nvitya/armpofo/README.md

# armpofo
Atari Portfolio Reloaded with ARM Cortex-M
