nvitya/armpofo/armpofo_cpu/armpofo_cpu.kicad_pcb

## KiCad design armpofo_cpu/armpofo_cpu.kicad_pcb (2020-11-24)

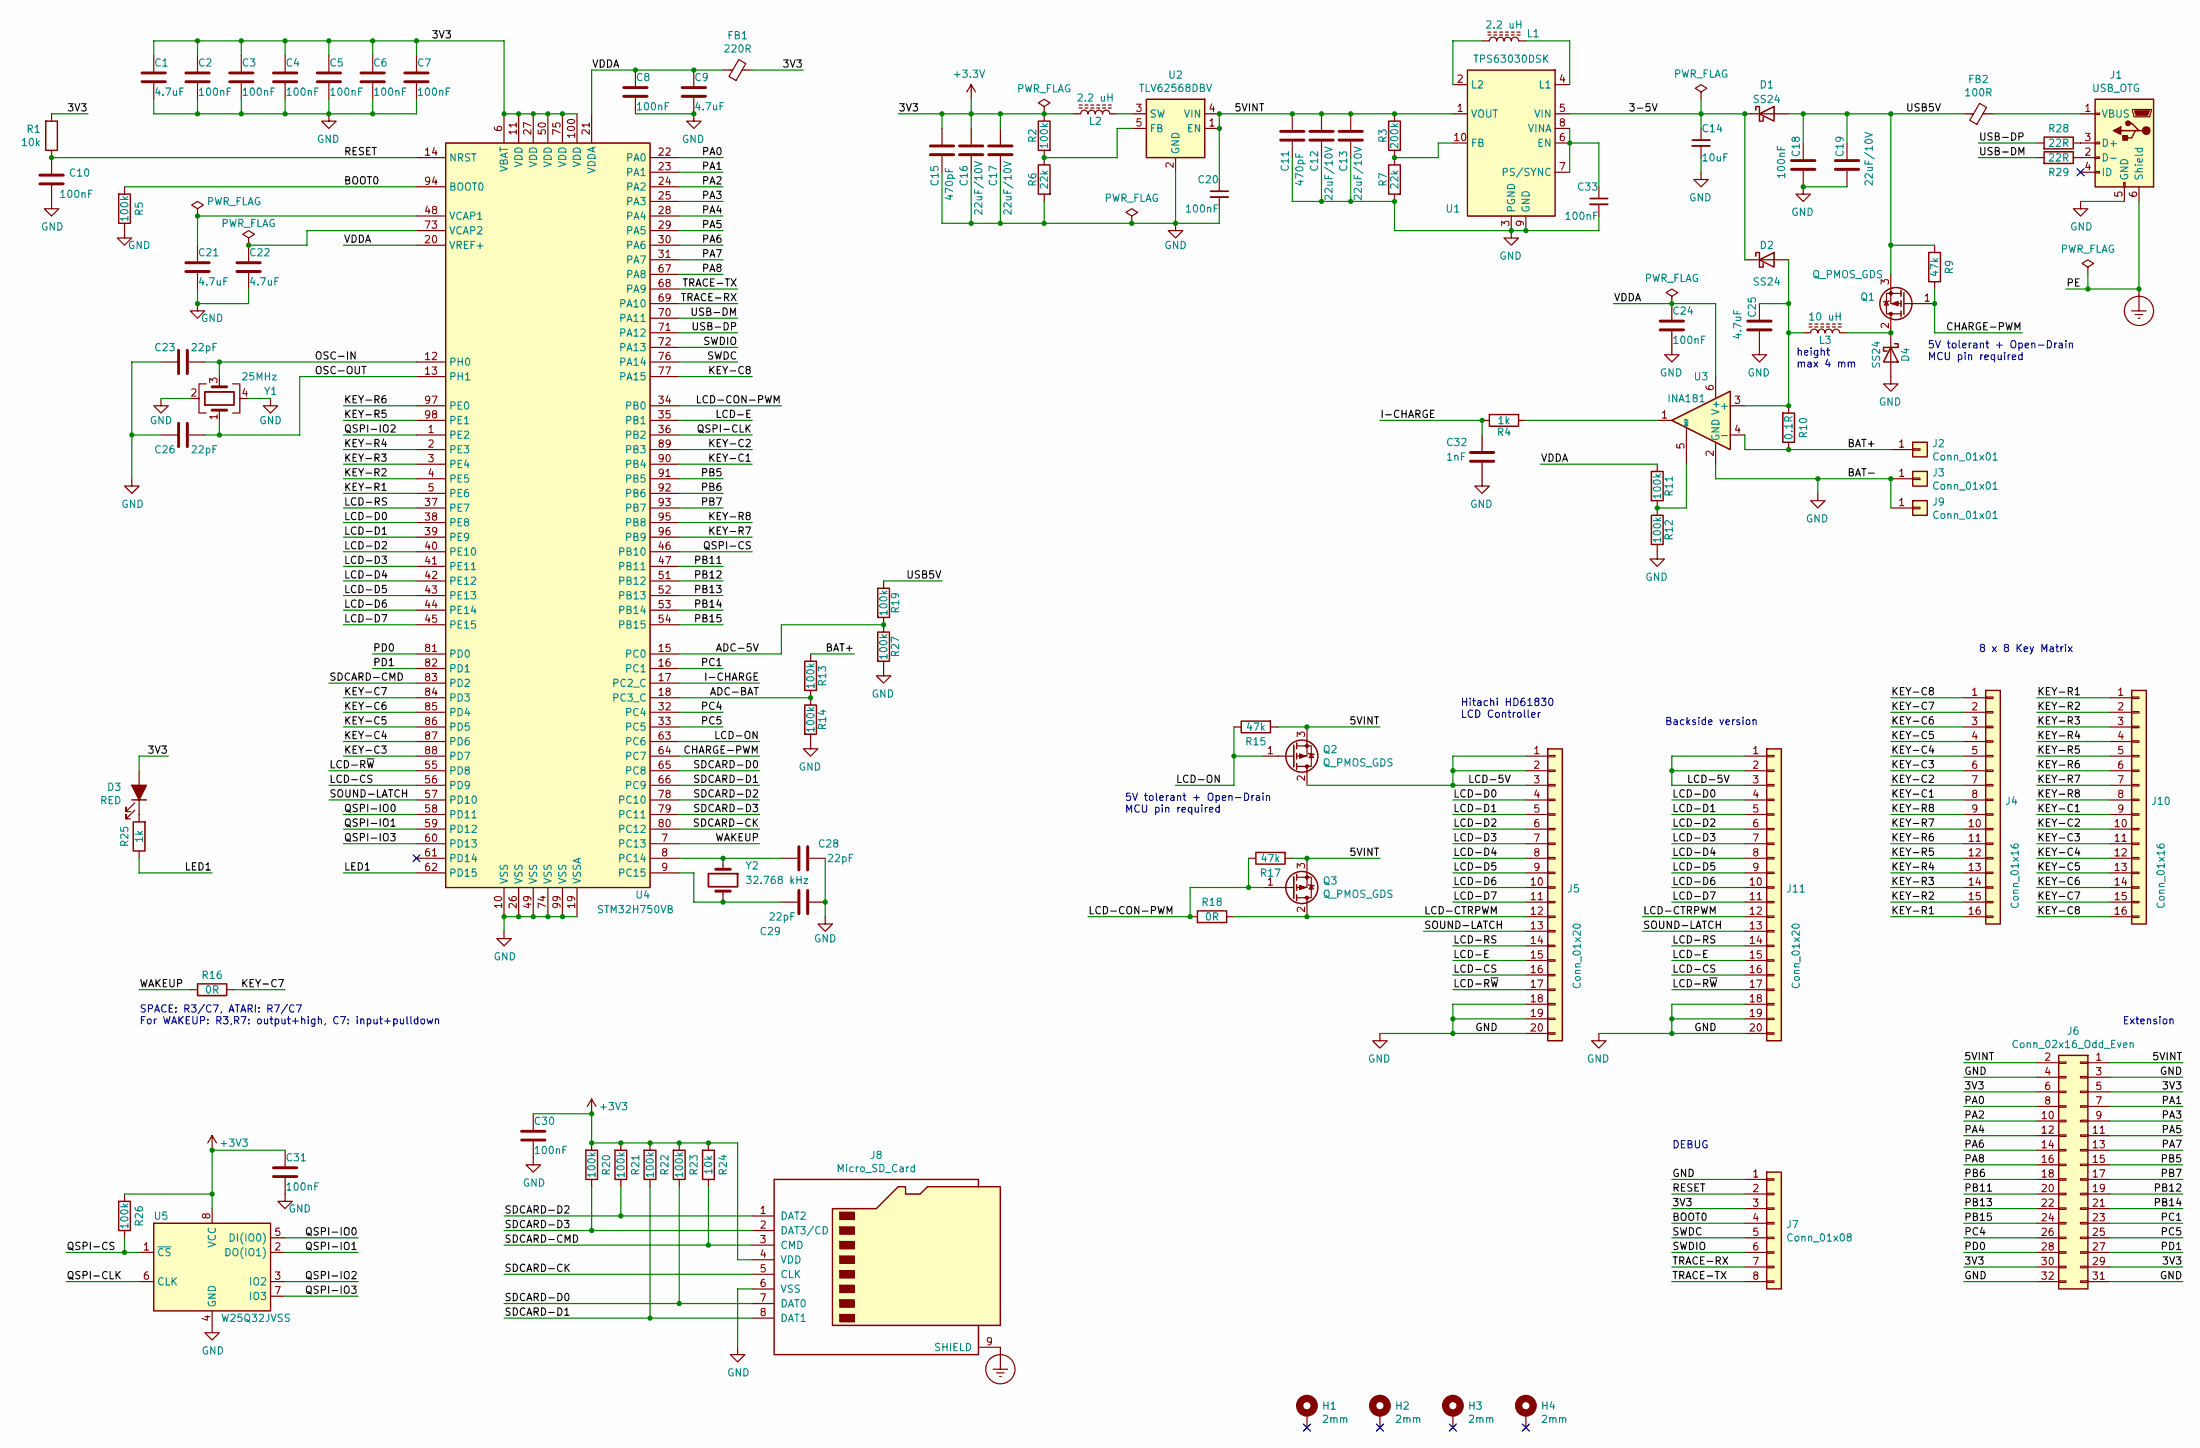
[picture p1: schematic armpofo_cpu.sch]

Parts:
C1, C9, C21, C22, C25: 4.7uF; C_0603_1608Metric
C2, C3, C4, C5, C6, C7, C8, C10, C18, C20, C24, C30, C31, C33: 100nF; C_0603_1608Metric
C11, C15: 470pF; C_0603_1608Metric
C12, C13, C16, C17, C19: 22uF/10V; C_1210_3225Metric
C14: 10uF; C_1210_3225Metric
C23, C26, C28, C29: 22pF; C_0603_1608Metric
C32: 1nF; C_0603_1608Metric
D1, D2, D4: SS24; D_1206_3216Metric
D3: RED; D_0603_1608Metric
FB1: 220R; L_0603_1608Metric
FB2: 100R; L_0603_1608Metric
H1, H2, H3, H4: 2mm; MountingHole_2.2mm_M2_DIN965_Pad
J1: USB_OTG; USB_Micro-B_Molex-105017-0001
J2, J3, J9: Conn_01x01; PinHeader_1x01_P2.54mm_Vertical
J4: Conn_01x16; TE_1-84953-6_1x16-1MP_P1.0mm_Horizontal
J5, J11: Conn_01x20; TE_2-84952-0_1x20-1MP_P1.0mm_Horizontal
J6: Conn_02x16_Odd_Even; Conn_Edge_PinSocket_2x16_2.54mm
J7: Conn_01x08; PinHeader_1x08_P2.54mm_Horizontal
J8: Micro_SD_Card; Conn_uSDcard
J10: Conn_01x16; PinHeader_1x16_P1.27mm_Vertical
L1, L2: 2.2 uH; L_Taiyo-Yuden_NR-40xx_HandSoldering
L3: 10 uH; L_Taiyo-Yuden_NR-40xx_HandSoldering
Q1, Q2, Q3: Q_PMOS_GDS; SOT-23
R1, R24: 10k; R_0603_1608Metric
R2, R5, R11, R12, R13, R14, R19, R20, R21, R22, R23, R26, R27: 100k; R_0603_1608Metric
R3: 200k; R_0603_1608Metric
R4, R25: 1k; R_0603_1608Metric
R6, R7: 22k; R_0603_1608Metric
R9, R15, R17: 47k; R_0603_1608Metric
R10: 0.1R; R_1206_3216Metric
R16, R18: 0R; R_0603_1608Metric
R28, R29: 22R; R_0603_1608Metric
U1: TPS63030DSK; WSON-10-1EP_2.5x2.5mm_P0.5mm_EP1.2x2mm
U2: TLV62568DBV; SOT-23-5
U3: INA181; SOT-23-6
U4: STM32H750VB; LQFP-100_14x14mm_P0.5mm
U5: W25Q32JVSS; SO-8_5.3x6.2mm_P1.27mm
Y1: 25MHz; Crystal_SMD_3225-4Pin_3.2x2.5mm
Y2: 32.768 kHz; Crystal_DS26_D2.0mm_L6.0mm_Horizontal_1EP_style1

Connections:
/3-5V: C14.1, D1.1 (K), D2.1 (K), U1.5 (VIN)
/5VINT: C11.1, C12.1, C13.1, C20.1, J6.1, J6.2, Q2.3 (S), Q3.3 (S), R3.1, R15.2, R17.2, U1.1 (VOUT), U2.1 (EN), U2.4 (VIN)
/ADC-5V: R19.2, R27.1, U4.15 (PC0)
/ADC-BAT: R13.2, R14.1, U4.18 (PC3_C)
/BAT+: J2.1, R10.1, R13.1, U3.4 (-)
/BOOT0: J7.4, R5.2, U4.94 (BOOT0)
/CHARGE-PWM: Q1.1 (G), R9.1, U4.64 (PC7)
/I-CHARGE: C32.1, R4.2, U4.17 (PC2_C)
/KEY-C1: J4.8, J10.9, U4.90 (PB4)
/KEY-C2: J4.7, J10.10, U4.89 (PB3)
/KEY-C3: J4.6, J10.11, U4.88 (PD7)
/KEY-C4: J4.5, J10.12, U4.87 (PD6)
/KEY-C5: J4.4, J10.13, U4.86 (PD5)
/KEY-C6: J4.3, J10.14, U4.85 (PD4)
/KEY-C7: J4.2, J10.15, R16.1, U4.84 (PD3)
/KEY-C8: J4.1, J10.16, U4.77 (PA15)
/KEY-R1: J4.16, J10.1, U4.5 (PE6)
/KEY-R2: J4.15, J10.2, U4.4 (PE5)
/KEY-R3: J4.14, J10.3, U4.3 (PE4)
/KEY-R4: J4.13, J10.4, U4.2 (PE3)
/KEY-R5: J4.12, J10.5, U4.98 (PE1)
/KEY-R6: J4.11, J10.6, U4.97 (PE0)
/KEY-R7: J4.10, J10.7, U4.96 (PB9)
/KEY-R8: J4.9, J10.8, U4.95 (PB8)
/LCD-5V: J5.1, J5.2, J5.3, J11.1, J11.2, J11.3, Q2.2 (D)
/LCD-CON-PWM: Q3.1 (G), R17.1, R18.2, U4.34 (PB0)
/LCD-CS: J5.16, J11.16, U4.56 (PD9)
/LCD-CTRPWM: J5.12, J11.12, Q3.2 (D), R18.1
/LCD-D0: J5.4, J11.4, U4.38 (PE8)
/LCD-D1: J5.5, J11.5, U4.39 (PE9)
/LCD-D2: J5.6, J11.6, U4.40 (PE10)
/LCD-D3: J5.7, J11.7, U4.41 (PE11)
/LCD-D4: J5.8, J11.8, U4.42 (PE12)
/LCD-D5: J5.9, J11.9, U4.43 (PE13)
/LCD-D6: J5.10, J11.10, U4.44 (PE14)
/LCD-D7: J5.11, J11.11, U4.45 (PE15)
/LCD-E: J5.15, J11.15, U4.35 (PB1)
/LCD-ON: Q2.1 (G), R15.1, U4.63 (PC6)
/LCD-RS: J5.14, J11.14, U4.37 (PE7)
/LCD-R~W: J5.17, J11.17, U4.55 (PD8)
/LED1: R25.1, U4.62 (PD15)
/OSC-IN: C23.1, U4.12 (PH0), Y1.3
/OSC-OUT: C26.1, U4.13 (PH1), Y1.1
/PA0: J6.8, U4.22 (PA0)
/PA1: J6.7, U4.23 (PA1)
/PA2: J6.10, U4.24 (PA2)
/PA3: J6.9, U4.25 (PA3)
/PA4: J6.12, U4.28 (PA4)
/PA5: J6.11, U4.29 (PA5)
/PA6: J6.14, U4.30 (PA6)
/PA7: J6.13, U4.31 (PA7)
/PA8: J6.16, U4.67 (PA8)
/PB5: J6.15, U4.91 (PB5)
/PB6: J6.18, U4.92 (PB6)
/PB7: J6.17, U4.93 (PB7)
/PB11: J6.20, U4.47 (PB11)
/PB12: J6.19, U4.51 (PB12)
/PB13: J6.22, U4.52 (PB13)
/PB14: J6.21, U4.53 (PB14)
/PB15: J6.24, U4.54 (PB15)
/PC1: J6.23, U4.16 (PC1)
/PC4: J6.26, U4.32 (PC4)
/PC5: J6.25, U4.33 (PC5)
/PD0: J6.28, U4.81 (PD0)
/PD1: J6.27, U4.82 (PD1)
/QSPI-CLK: U4.36 (PB2), U5.6 (CLK)
/QSPI-CS: R26.1, U4.46 (PB10), U5.1 (~CS)
/QSPI-IO0: U4.58 (PD11), U5.5 (DI(IO0))
/QSPI-IO1: U4.59 (PD12), U5.2 (DO(IO1))
/QSPI-IO2: U4.1 (PE2), U5.3 (IO2)
/QSPI-IO3: U4.60 (PD13), U5.7 (IO3)
/RESET: C10.1, J7.2, R1.1, U4.14 (NRST)
/SDCARD-CK: J8.5 (CLK), U4.80 (PC12)
/SDCARD-CMD: J8.3 (CMD), R24.1, U4.83 (PD2)
/SDCARD-D0: J8.7 (DAT0), R23.1, U4.65 (PC8)
/SDCARD-D1: J8.8 (DAT1), R22.1, U4.66 (PC9)
/SDCARD-D2: J8.1 (DAT2), R21.1, U4.78 (PC10)
/SDCARD-D3: J8.2 (DAT3/CD), R20.1, U4.79 (PC11)
/SOUND-LATCH: J5.13, J11.13, U4.57 (PD10)
/SWDC: J7.5, U4.76 (PA14)
/SWDIO: J7.6, U4.72 (PA13)
/TRACE-RX: J7.7, U4.69 (PA10)
/TRACE-TX: J7.8, U4.68 (PA9)
/USB5V: C18.1, C19.1, D1.2 (A), FB2.1, Q1.3 (S), R9.2, R19.1
/USB-DM: R29.2, U4.70 (PA11)
/USB-DP: R28.2, U4.71 (PA12)
/VDDA: C8.1, C9.1, C24.1, FB1.1, R11.1, U3.6 (V+), U4.20 (VREF+), U4.21 (VDDA)
/WAKEUP: R16.2, U4.7 (PC13)
Earth_Protective: J1.6 (Shield), J8.9 (SHIELD)
GND: C1.2, C2.2, C3.2, C4.2, C5.2, C6.2, C7.2, C8.2, C9.2, C10.2, C11.2, C12.2, C13.2, C14.2, C15.2, C16.2, C17.2, C18.2, C19.2, C20.2, C21.2, C22.2, C23.2, C24.2, C25.2, C26.2, C28.2, C29.2, C30.2, C31.2, C32.2, C33.2, D4.2 (A), J1.5 (GND), J3.1, J5.18, J5.19, J5.20, J6.3, J6.4, J6.31, J6.32, J7.1, J8.6 (VSS), J9.1, J11.18, J11.19, J11.20, R5.1, R6.2, R7.2, R12.2, R14.2, R27.2, U1.3 (PGND), U1.9 (GND), U1.11 (PGND), U2.2 (GND), U3.2 (GND), U4.10 (VSS), U4.19 (VSSA), U4.26 (VSS), U4.49 (VSS), U4.74 (VSS), U4.99 (VSS), U5.4 (GND), Y1.2, Y1.4
unnamed: C21.1, U4.48 (VCAP1)
unnamed: C22.1, U4.73 (VCAP2)
unnamed: C25.1, D2.2 (A), L3.2, R10.2, U3.3 (+)
unnamed: C28.1, U4.8 (PC14), Y2.1
unnamed: C29.1, U4.9 (PC15), Y2.2
unnamed: C33.1, U1.6 (EN), U1.7 (PS/SYNC), U1.8 (VINA)
unnamed: D3.1 (K), R25.2
unnamed: D4.1 (K), L3.1, Q1.2 (D)
unnamed: FB2.2, J1.1 (VBUS)
unnamed: J1.2 (D-), R29.1
unnamed: J1.3 (D+), R28.1
unnamed: L1.1, U1.4 (L1)
unnamed: L1.2, U1.2 (L2)
unnamed: L2.1, U2.3 (SW)
unnamed: R2.2, R6.1, U2.5 (FB)
unnamed: R3.2, R7.1, U1.10 (FB)
unnamed: R4.1, U3.1
unnamed: R11.2, R12.1, U3.5 (REF)

Notes on the sheet:
Hitachi HD61830 LCD Controller
8 x 8 Key Matrix
Extension
DEBUG
5V tolerant + Open-Drain MCU pin required
height max 4 mm
SPACE: R3/C7, ATARI: R7/C7 For WAKEUP: R3,R7: output+high, C7: input+pulldown
Backside version

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
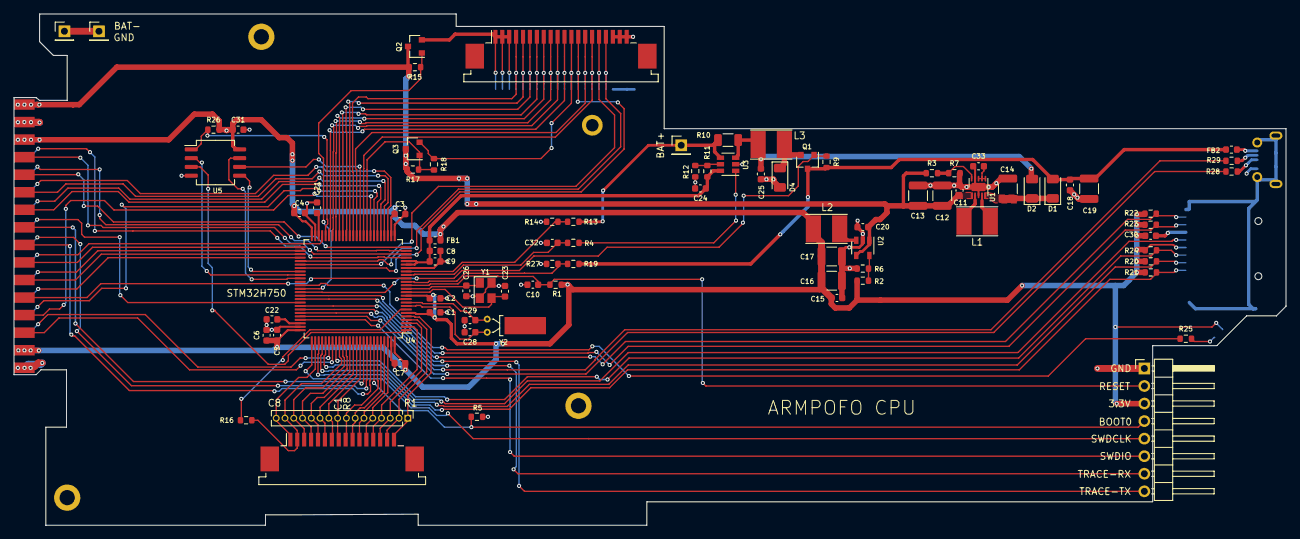
[picture p2: board armpofo_cpu.kicad_pcb from above]

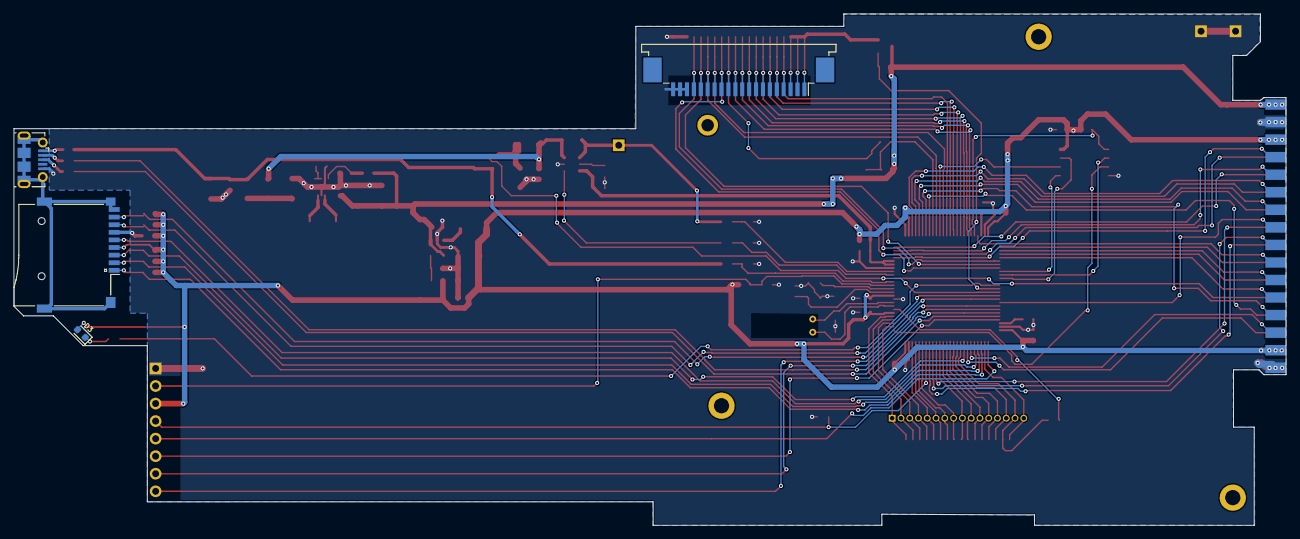
[picture p3: board armpofo_cpu.kicad_pcb from below]

Board: 2 copper layers, 184.1 x 74.0 mm, 94 parts (4 on the bottom side), 109 nets.
