nvitya/armpofo/armpofo_keyboard/armpofo_keyboard.kicad_pcb

## KiCad design armpofo_keyboard/armpofo_keyboard.kicad_pcb (2020-11-24)

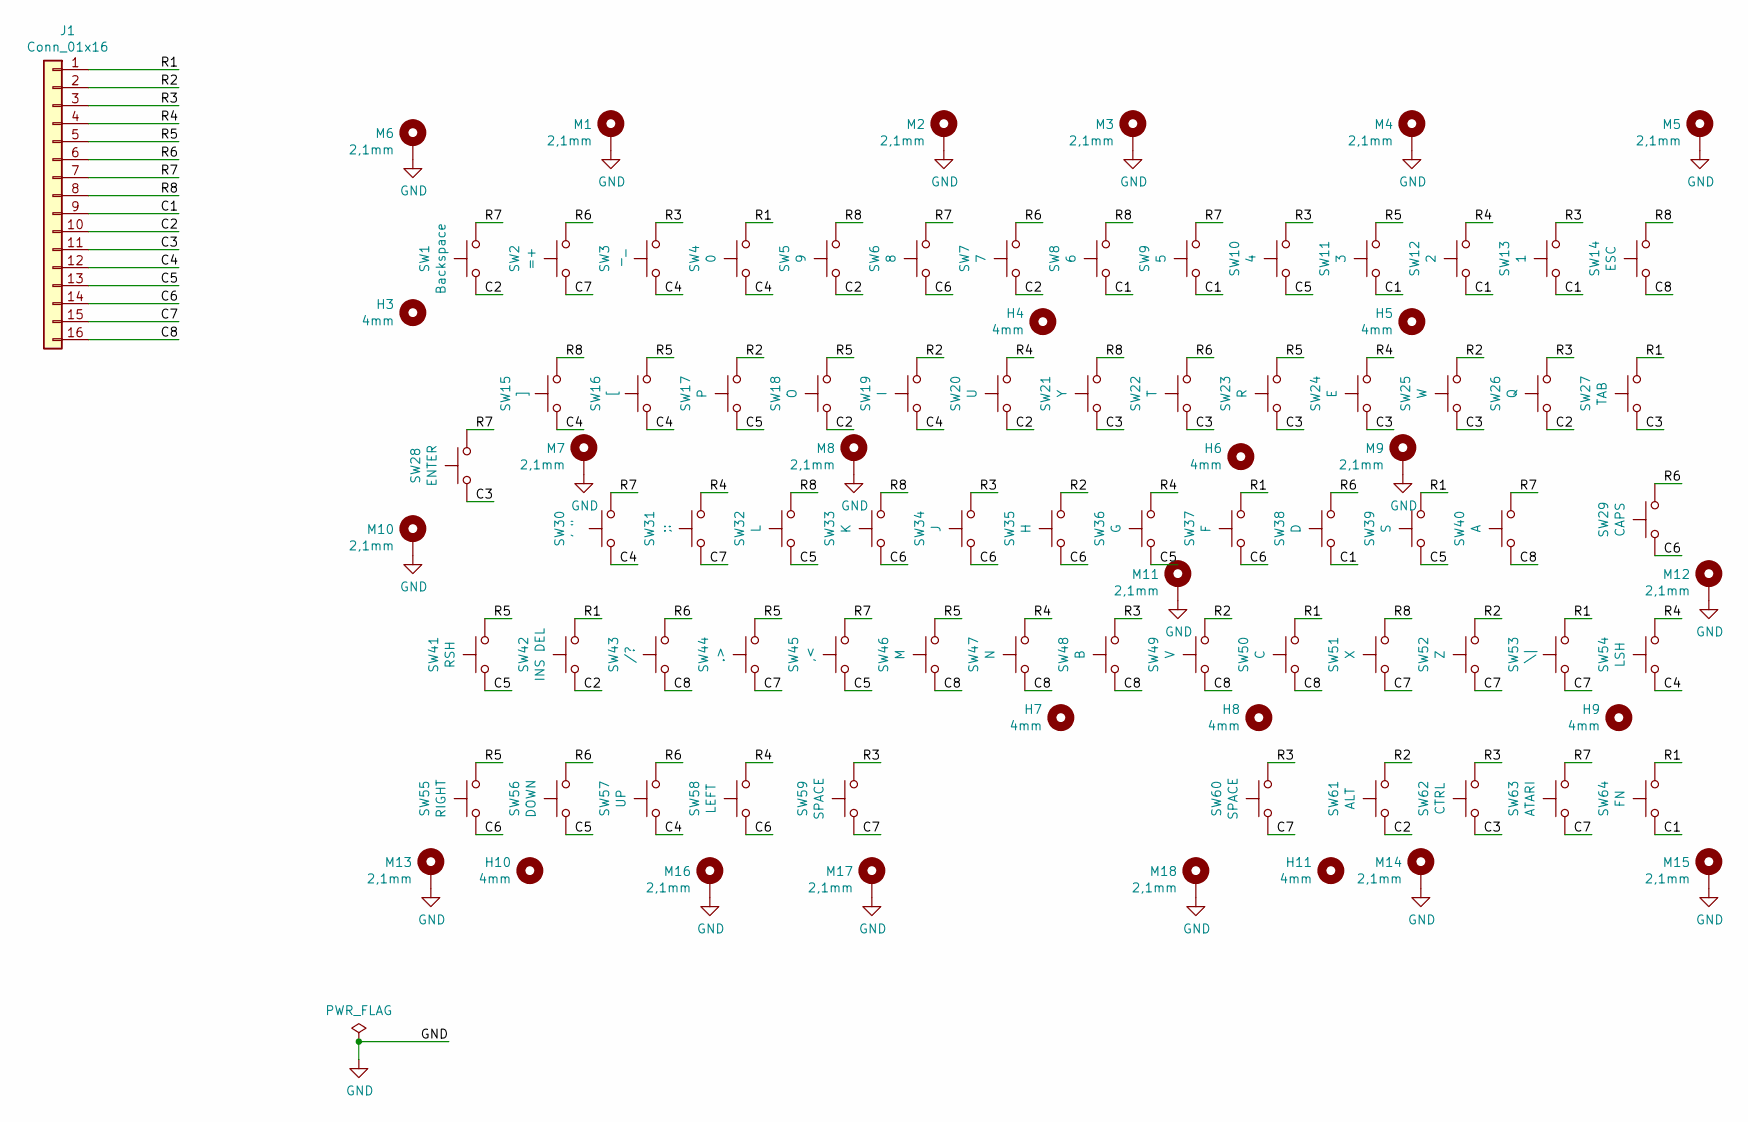
[picture p4: schematic armpofo_keyboard.sch]

Parts:
H3, H4, H5, H6, H7, H8, H9, H10, H11: 4mm; MountingHole_4mm
J1: Conn_01x16; TE_1-84953-6_1x16-1MP_P1.0mm_Horizontal
M1, M2, M3, M4, M5, M6, M7, M8, M9, M10, M11, M12, M13, M14, M15, M16, M17, M18: 2,1mm; MountingHole_2.2mm_M2_DIN965_Pad
SW1: Backspace; Key_landing
SW2: =+; Key_landing
SW3: -_; Key_landing
SW4: 0; Key_landing
SW5: 9; Key_landing
SW6: 8; Key_landing
SW7: 7; Key_landing
SW8: 6; Key_landing
SW9: 5; Key_landing
SW10: 4; Key_landing
SW11: 3; Key_landing
SW12: 2; Key_landing
SW13: 1; Key_landing
SW14: ESC; Key_landing
SW15: ]; Key_landing
SW16: [; Key_landing
SW17: P; Key_landing
SW18: O; Key_landing
SW19: I; Key_landing
SW20: U; Key_landing
SW21: Y; Key_landing
SW22: T; Key_landing
SW23: R; Key_landing
SW24: E; Key_landing
SW25: W; Key_landing
SW26: Q; Key_landing
SW27: TAB; Key_landing
SW28: ENTER; Key_landing
SW29: CAPS; Key_landing
SW30: ' \"; Key_landing
SW31: ;:; Key_landing
SW32: L; Key_landing
SW33: K; Key_landing
SW34: J; Key_landing
SW35: H; Key_landing
SW36: G; Key_landing
SW37: F; Key_landing
SW38: D; Key_landing
SW39: S; Key_landing
SW40: A; Key_landing
SW41: RSH; Key_landing
SW42: INS DEL; Key_landing
SW43: /?; Key_landing
SW44: .>; Key_landing
SW45: ,<; Key_landing
SW46: M; Key_landing
SW47: N; Key_landing
SW48: B; Key_landing
SW49: V; Key_landing
SW50: C; Key_landing
SW51: X; Key_landing
SW52: Z; Key_landing
SW53: \\|; Key_landing
SW54: LSH; Key_landing
SW55: RIGHT; Key_landing
SW56: DOWN; Key_landing
SW57: UP; Key_landing
SW58: LEFT; Key_landing
SW59, SW60: SPACE; Key_landing
SW61: ALT; Key_landing
SW62: CTRL; Key_landing
SW63: ATARI; Key_landing
SW64: FN; Key_landing

Connections:
/C1: J1.9, SW8.2, SW9.2, SW11.2, SW12.2, SW13.2, SW38.2, SW64.2
/C2: J1.10, SW1.2, SW5.2, SW7.2, SW18.2, SW20.2, SW26.2, SW42.2, SW61.2
/C3: J1.11, SW21.2, SW22.2, SW23.2, SW24.2, SW25.2, SW27.2, SW28.2, SW62.2
/C4: J1.12, SW3.2, SW4.2, SW15.2, SW16.2, SW19.2, SW30.2, SW54.2, SW57.2
/C5: J1.13, SW10.2, SW17.2, SW32.2, SW36.2, SW39.2, SW41.2, SW45.2, SW56.2
/C6: J1.14, SW6.2, SW29.2, SW33.2, SW34.2, SW35.2, SW37.2, SW55.2, SW58.2
/C7: J1.15, SW2.2, SW31.2, SW44.2, SW51.2, SW52.2, SW53.2, SW59.2, SW60.2, SW63.2
/C8: J1.16, SW14.2, SW40.2, SW43.2, SW46.2, SW47.2, SW48.2, SW49.2, SW50.2
/R1: J1.1, SW4.1, SW27.1, SW37.1, SW39.1, SW42.1, SW50.1, SW53.1, SW64.1
/R2: J1.2, SW17.1, SW19.1, SW25.1, SW35.1, SW49.1, SW52.1, SW61.1
/R3: J1.3, SW3.1, SW10.1, SW13.1, SW26.1, SW34.1, SW48.1, SW59.1, SW60.1, SW62.1
/R4: J1.4, SW12.1, SW20.1, SW24.1, SW31.1, SW36.1, SW47.1, SW54.1, SW58.1
/R5: J1.5, SW11.1, SW16.1, SW18.1, SW23.1, SW41.1, SW44.1, SW46.1, SW55.1
/R6: J1.6, SW2.1, SW7.1, SW22.1, SW29.1, SW38.1, SW43.1, SW56.1, SW57.1
/R7: J1.7, SW1.1, SW6.1, SW9.1, SW28.1, SW30.1, SW40.1, SW45.1, SW63.1
/R8: J1.8, SW5.1, SW8.1, SW14.1, SW15.1, SW21.1, SW32.1, SW33.1, SW51.1
GND: M1.1, M2.1, M3.1, M4.1, M5.1, M6.1, M7.1, M8.1, M9.1, M10.1, M11.1, M12.1, M13.1, M14.1, M15.1, M16.1, M17.1, M18.1

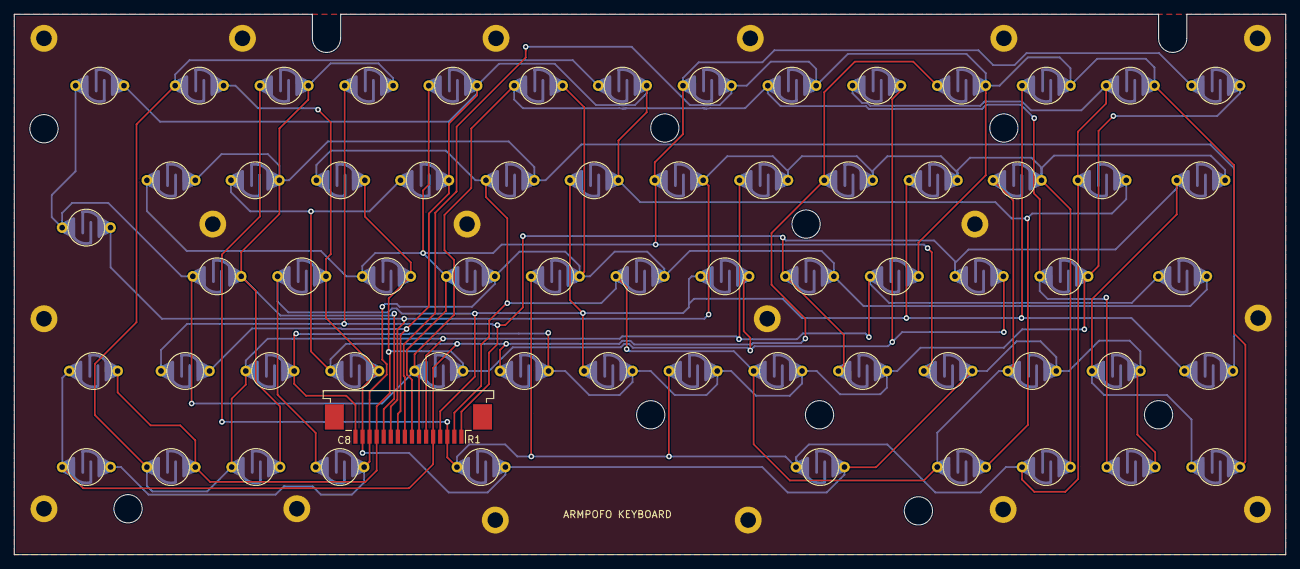
[picture p5: board armpofo_keyboard.kicad_pcb from above]

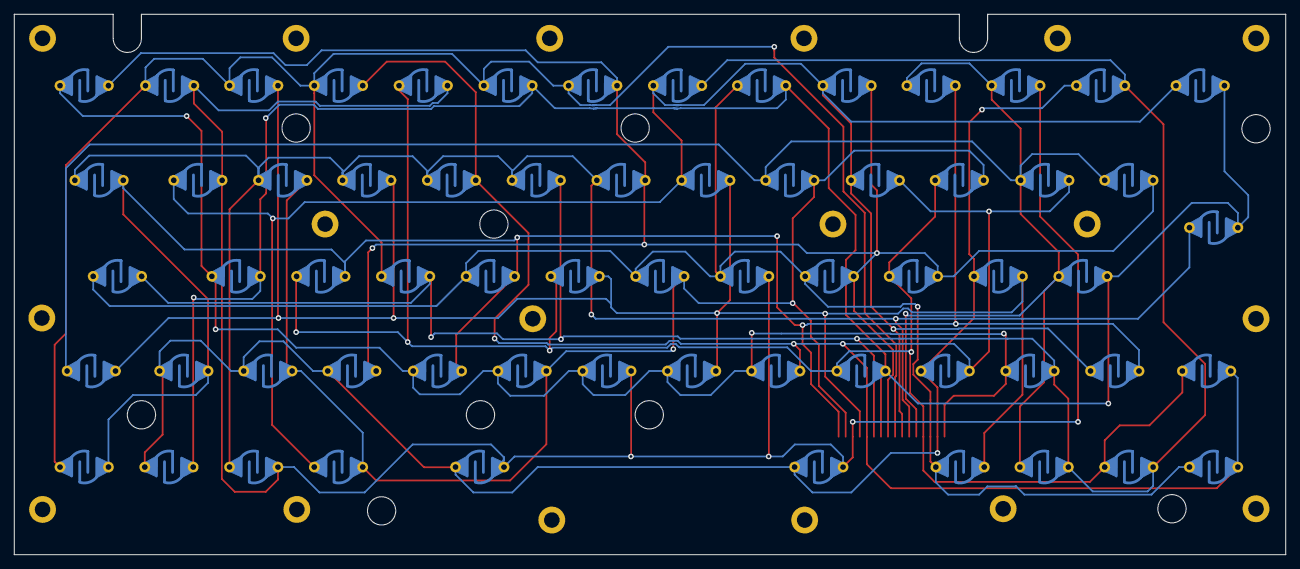
[picture p6: board armpofo_keyboard.kicad_pcb from below]

Board: 2 copper layers, 180.0 x 76.5 mm, 92 parts (64 on the bottom side), 17 nets.
