nvitya/armpofo/armpofo_cpu/cubemx/cubemx.ioc

PD12.GPIO_Label=QSPI-IO1
PC12.Signal=SDMMC1_CK
PB13.Signal=ETH_TXD1
PD6.GPIO_Label=KEY-R5
PE6.GPIO_Label=KEY-C8
PD4.Signal=GPIO_Output
PB6.Signal=FDCAN2_TX
PD0.Signal=FDCAN1_RX
PD8.Signal=GPIO_Output
PE5.Signal=GPIO_Output
PE1.Signal=GPIO_Output
PB2.Signal=QUADSPI_CLK
PE9.Signal=GPIO_Output
PB1.GPIO_Label=LCD-E
PE4.GPIO_Label=KEY-C6
PE2.Signal=QUADSPI_BK1_IO2
PA8.Signal=RCC_MCO_1
PE10.Signal=GPIO_Output
PA0.Signal=ADC1_INP16
PB9.Signal=GPIO_Output
PB1.Signal=GPIO_Output
PD12.Signal=QUADSPI_BK1_IO1
PC3_C.GPIO_Label=ADC_VBAT
PA10.Signal=USART1_RX
PE12.GPIO_Label=LCD-D4
PE10.GPIO_Label=LCD-D2
PD9.GPIO_Label=LCD-CS
PA9.GPIO_Label=TRACE-TX
PC13.Signal=PWR_WKUP2
PD3.Signal=GPIO_Output
PD7.Signal=GPIO_Output
PD1.Signal=FDCAN1_TX
PA11.GPIO_Label=USB-DM
PD10.Signal=GPIO_Output
PB8.GPIO_Label=KEY-C1
PE8.GPIO_Label=LCD-D0
PA9.Signal=USART1_TX
PE9.GPIO_Label=LCD-D1
PB10.Signal=QUADSPI_BK1_NCS
PB14.Signal=USB_OTG_HS_DM
PA5.Signal=COMP_DAC12_group
PE1.GPIO_Label=KEY-C4
PE14.Signal=GPIO_Output
PE15.Signal=GPIO_Output
PE8.Signal=GPIO_Output
PA4.Signal=COMP_DAC11_group
PB5.Signal=FDCAN2_RX
PE13.GPIO_Label=LCD-D5
PD11.Signal=QUADSPI_BK1_IO0
PE5.GPIO_Label=KEY-C7
PC12.GPIO_Label=SDCARD-CK
PA11.Signal=USB_OTG_FS_DM
PE3.Signal=GPIO_Output
PD2.Signal=SDMMC1_CMD
PB0.Signal=GPIO_Output
PC1.Signal=ETH_MDC
PD2.GPIO_Label=SDCARD-CMD
Mcu.UserName=STM32H750VBTx
PE11.GPIO_Label=LCD-D3
PC10.Signal=SDMMC1_D2
PB0.GPIO_Label=LCD-CON-PWM
PB11.Signal=ETH_TX_EN
PB15.Signal=USB_OTG_HS_DP
PD13.Signal=QUADSPI_BK1_IO3
PA12.Signal=USB_OTG_FS_DP
PD11.GPIO_Label=QSPI-IO0
PE13.Signal=GPIO_Output
PC11.GPIO_Label=SDCARD-D3
PA10.GPIO_Label=TRACE-RX
PB7.Signal=I2C1_SDA
PE4.Signal=GPIO_Output
PD7.GPIO_Label=KEY-R6
PD13.GPIO_Label=QSPI-IO3
PA6.Signal=ADCx_INP3
PD5.GPIO_Label=KEY-R4
PE0.GPIO_Label=KEY-C3
PC5.Signal=ETH_RXD1
PD3.GPIO_Label=KEY-R2
PE7.Signal=GPIO_Output
PD6.Signal=GPIO_Output
PE2.GPIO_Label=QSPI-IO2
PA3.Signal=ADCx_INP15
PB9.GPIO_Label=KEY-C2
PC10.GPIO_Label=SDCARD-D2
PC9.GPIO_Label=SDCARD-D1
PC11.Signal=SDMMC1_D3
PC8.Signal=SDMMC1_D0
PC4.Signal=ETH_RXD0
PE14.GPIO_Label=LCD-D6
PD9.Signal=GPIO_Output
PD5.Signal=GPIO_Output
PA12.GPIO_Label=USB-DP
PD8.GPIO_Label=LCD-RW
PC8.GPIO_Label=SDCARD-D0
PE15.GPIO_Label=LCD-D7
PB10.GPIO_Label=QSPI-CS
PD10.GPIO_Label=SOUND-LATCH
PE11.Signal=GPIO_Output
PA1.Signal=ETH_REF_CLK
PD4.GPIO_Label=KEY-R3
PE6.Signal=GPIO_Output
PE0.Signal=GPIO_Output
PE7.GPIO_Label=LCD-RS
PE12.Signal=GPIO_Output
PA2.Signal=ETH_MDIO
PB2.GPIO_Label=QSPI-CLK
PC3_C.Signal=ADC3_INP1
PB8.Signal=GPIO_Output
PE3.GPIO_Label=KEY-C5
PC9.Signal=SDMMC1_D1
PB12.Signal=ETH_TXD0
PA7.Signal=ETH_CRS_DV
