nvitya/armpofo/sw/armpofo_sys/board/armpofo/board.h

/* -----------------------------------------------------------------------------
 * This file is a part of the NVCM Tests project: https://github.com/nvitya/nvcmtests
 * Copyright (c) 2018 Viktor Nagy, nvitya
 *
 * This software is provided 'as-is', without any express or implied warranty.
 * In no event will the authors be held liable for any damages arising from
 * the use of this software. Permission is granted to anyone to use this
 * software for any purpose, including commercial applications, and to alter
 * it and redistribute it freely, subject to the following restrictions:
 *
 * 1. The origin of this software must not be misrepresented; you must not
 *    claim that you wrote the original software. If you use this software in
 *    a product, an acknowledgment in the product documentation would be
 *    appreciated but is not required.
 *
 * 2. Altered source versions must be plainly marked as such, and must not be
 *    misrepresented as being the original software.
 *
 * 3. This notice may not be removed or altered from any source distribution.
 * --------------------------------------------------------------------------- */
/*
 *  file:     board/armpofo/board.h
 *  brief:    Board specific settings for the project
 *  version:  1.00
 *  date:     2020-12-04
 *  authors:  nvitya
*/

#ifndef BOARD_H_
#define BOARD_H_

#define BOARD_ARMPOFO
#define BOARD_NAME "ARMPOFO (Atari Portfolio Upgrade)"
#define MCU_STM32H750VB
#define MCU_INPUT_FREQ    12000000

#define PRINTF_SUPPORT_FULL

#define MCU_CLOCK_SPEED  100000000  // run only at 100 MHz to spare some energy

#define SYS_APPLICATION          0  // 0 = system

#endif /* BOARD_H_ */
