nvitya/armpofo/sw_tests/armpofo_hwtests/src/strparse.h

// strparse.h
//
// light string parser using pointers, avoiding copiing

#ifndef __STRPARSE_H_
#define __STRPARSE_H_

class TStrParseObj
{
  public:
    char * bufstart;
    char * bufend;

    char * readptr;    // current parsing position

    char * prevptr;    // usually signs token start
    int prevlen;       // usually signs token length

    char commentmarker = '#';

    TStrParseObj();
    TStrParseObj(char * astr, int buflen = 0);

    void Init(char * astr, int buflen = 0);

    void SkipSpaces(bool askiplineend = true);
    void SkipWhite();

    bool ReadLine();                 // sets prevptr, prevlen
    bool ReadTo(const char * checkchars);  // sets prevptr, prevlen
    bool ReadToChar(char achar);     // sets prevptr, prevlen
    bool ReadIdentifier();           // sets prevptr, prevlen
    bool ReadAlphaNum();             // sets prevptr, prevlen
    bool ReadDecimalNumbers();       // sets prevptr, prevlen
    bool ReadHexNumbers();           // sets prevptr, prevlen
    bool ReadQuotedString();
    bool CheckSymbol(const char * checkstring);
    bool SearchPattern(const char * checkchars);  // sets prevptr, prevlen

    double ParseFloatNumber();

    bool ComparePrev(const char * checkstring);
    bool UCComparePrev(const char * checkstring);
    int PrevToInt();
    unsigned PrevHexToInt();


    int GetLineNum(const char * pos);
    int GetLineNum();
};

typedef TStrParseObj *  PStrParseObj;

bool PCharCompare(char * * ReadPtr, int len, const char * checkstring);
bool PCharUCCompare(char * * ReadPtr, int len, const char * checkstring);
int PCharToInt(char * ReadPtr, int len);
unsigned PCharHexToInt(char * ReadPtr, int len);

#endif
