nvitya/armpofo/(commit log)

2020-10-11 keyboard pcb project added
    [armpofo_keyboard.kicad_pcb, armpofo_keyboard.sch]
2020-10-13 some progress with the CPU board
    [armpofo_cpu.kicad_pcb, armpofo_cpu.sch]
2020-10-17 cpu + ext pins finished
    [armpofo_cpu.sch]
2020-10-17 schematic almost finished
    [armpofo_cpu.sch]
2020-10-18 holes are arranged to their final place
    [armpofo_keyboard.kicad_pcb]
2020-10-19 key landing at the final positions
    [armpofo_keyboard.kicad_pcb]
2020-10-19 small align adjustments
    [armpofo_keyboard.kicad_pcb]
2020-10-19 edge cut correction
    [armpofo_keyboard.kicad_pcb, armpofo_keyboard.sch]
2020-10-19 routing finished
    [armpofo_keyboard.kicad_pcb, armpofo_keyboard.sch]
2020-10-23 cpu schematic finished
    [armpofo_cpu.kicad_pcb, armpofo_cpu.sch]
2020-10-25 - CPU board finalisch edge cuts - Keyboard mounting modified to 2.2 mm holes
    [armpofo_cpu.kicad_pcb, armpofo_cpu.sch, armpofo_keyboard.kicad_pcb, armpofo_keyboard.sch]
2020-10-25 final form
    [armpofo_cpu.kicad_pcb]
2020-10-26 some progress
    [armpofo_cpu.kicad_pcb, armpofo_cpu.sch]
2020-10-31 routing progress 70%
    [armpofo_cpu.kicad_pcb, armpofo_cpu.sch]
2020-10-31 routing finished.
    [armpofo_cpu.kicad_pcb, armpofo_cpu.sch]
2020-11-21 PCB corrections some items moved to the backside
    [armpofo_cpu.kicad_pcb, armpofo_cpu.sch]
2020-11-22 finalizing sizes, positions
    [armpofo_cpu.kicad_pcb, armpofo_cpu.sch]
2020-11-22 usb overstrecht corrected
    [armpofo_cpu.kicad_pcb]
2020-11-24 gerber files generated
    [armpofo_cpu-B_Cu.gbl, armpofo_cpu-B_Mask.gbs, armpofo_cpu-B_SilkS.gbo, armpofo_cpu-Edge_Cuts.gm1, armpofo_cpu-F_Cu.gtl, armpofo_cpu-F_Mask.gts, armpofo_cpu-F_SilkS.gto, armpofo_cpu-NPTH.drl]
2020-12-05 HW test project for the assembled STM32H750 Atari Portfolio
2020-12-06 working power-saving, the boost converter requires 5 mA unfortunately
2020-12-08 analogue measurement and battery charging
2020-12-08 some battery monitoring
2020-12-13 no adc init at the bootloader
2020-12-29 bl compile fixes, some simple tests
    [board.h, board_config.h, board_config_armpofo.cpp, main.cpp, qspiflashtest.cpp, qspiflashtest.h, syskeyboard.h, traces.cpp]
